k0bura/compaq-wifimodem/reference/photos/modem-top-both-connectors.jpg

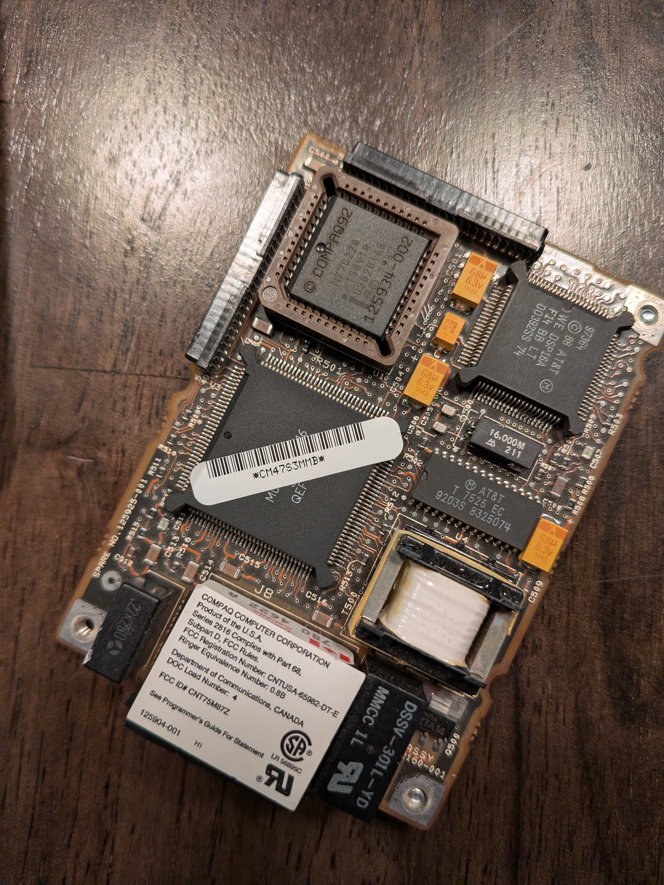
reference/photos/modem-top-both-connectors.jpg
