k0bura/compaq-wifimodem/reference/photos/modem-top-j4-removed.jpg

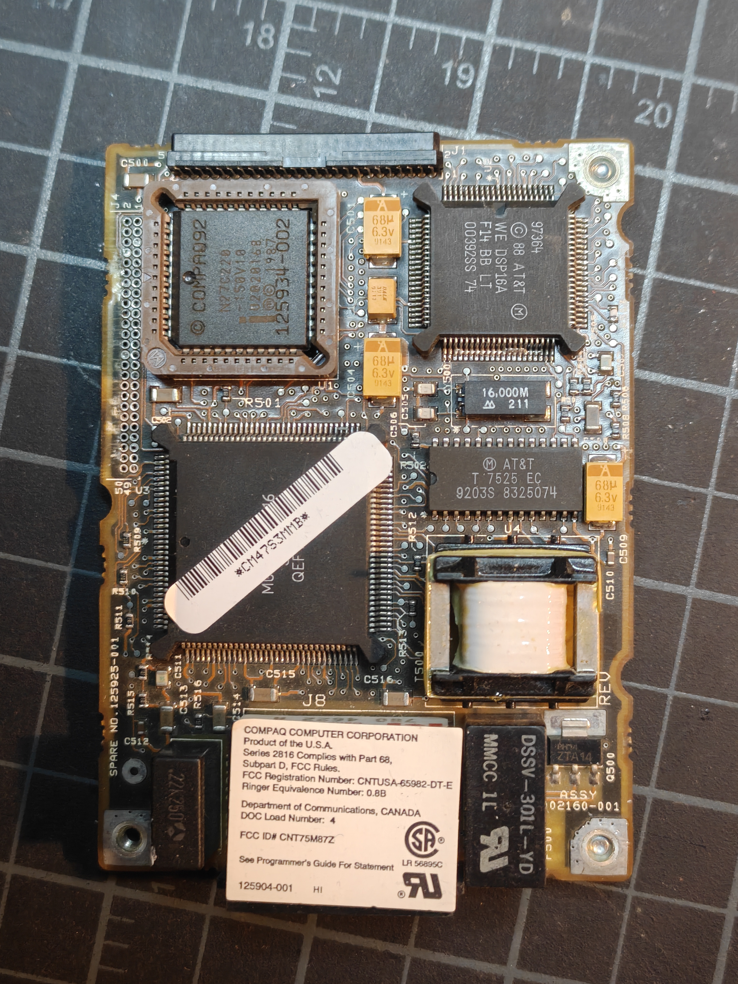
reference/photos/modem-top-j4-removed.jpg
