k0bura/compaq-wifimodem/reference/photos/modem-bottom.jpg

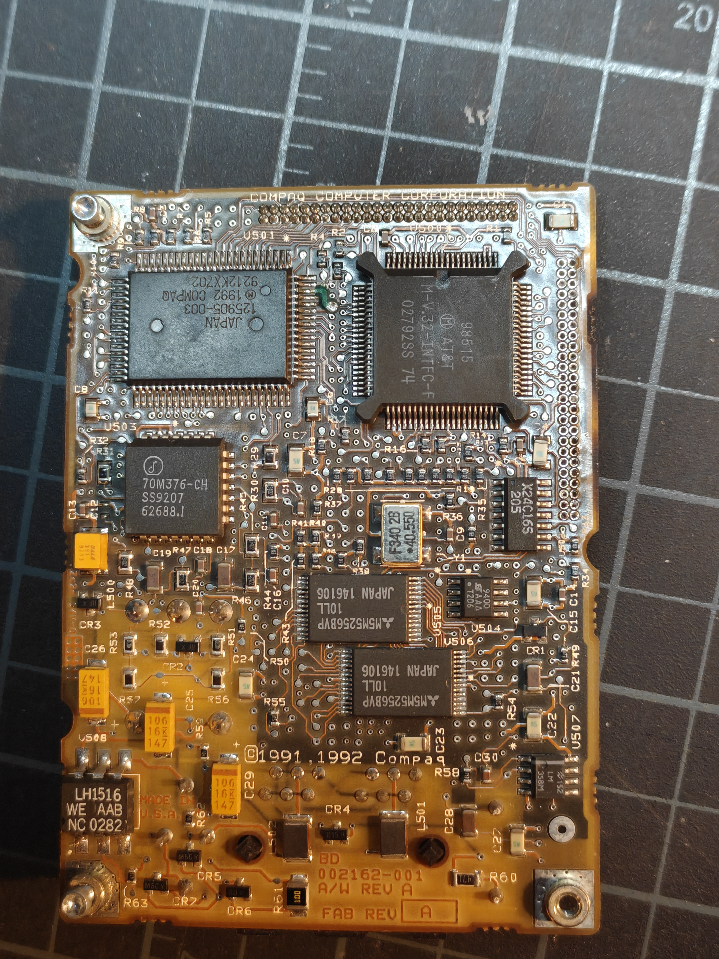
reference/photos/modem-bottom.jpg
