k0bura/compaq-wifimodem/reference/photos/modem-connector-edge-on.jpg

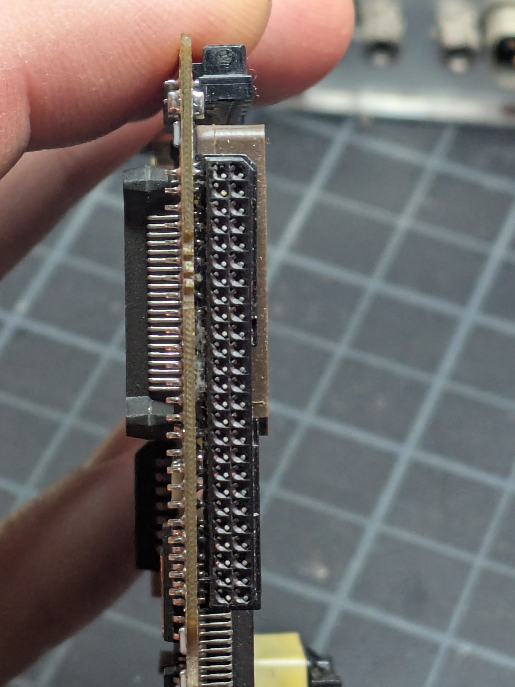
reference/photos/modem-connector-edge-on.jpg
