k0bura/compaq-wifimodem/reference/photos/modem-top-j4-removed-rotated.jpg

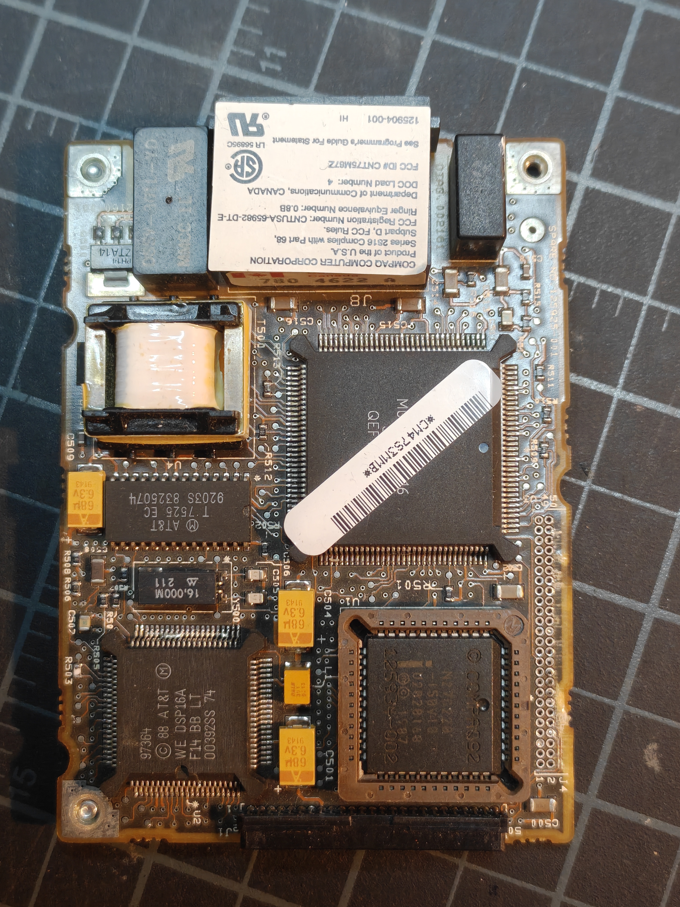
reference/photos/modem-top-j4-removed-rotated.jpg
