k0bura/compaq-wifimodem/reference/photos/slot-j22-closeup.jpg

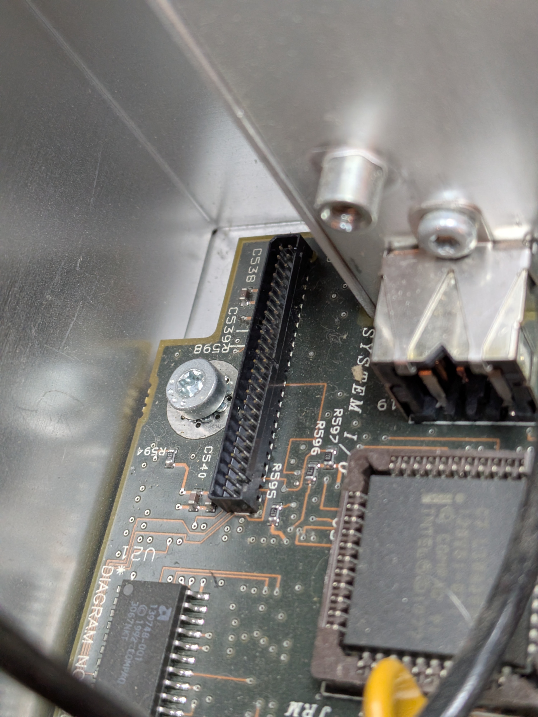
reference/photos/slot-j22-closeup.jpg
