k0bura/compaq-wifimodem/reference/photos/slot-j22-system-io-board.jpg

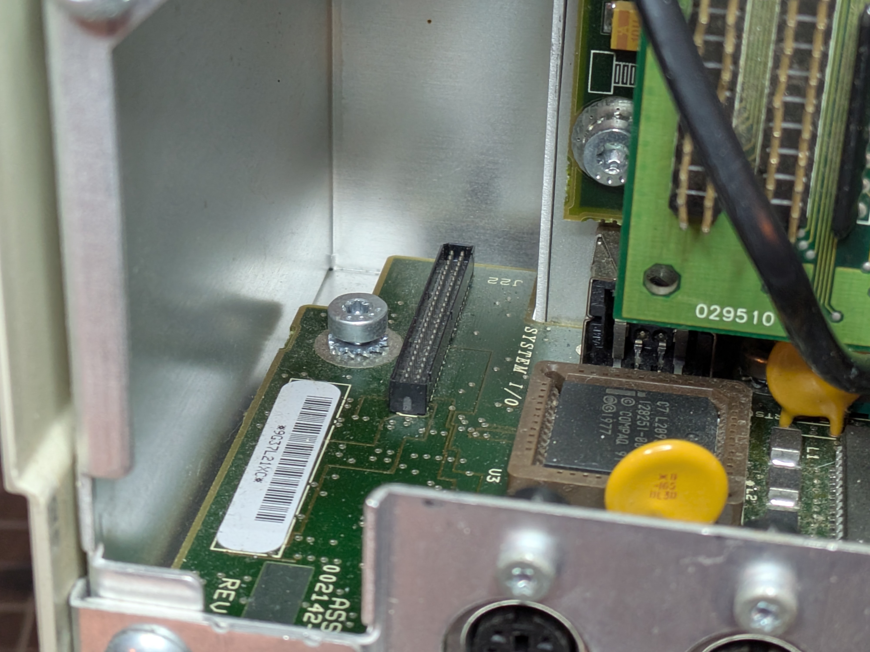
reference/photos/slot-j22-system-io-board.jpg
