k0bura/compaq-wifimodem/hardware/eos-breakout/eos-breakout-1to1.pdf

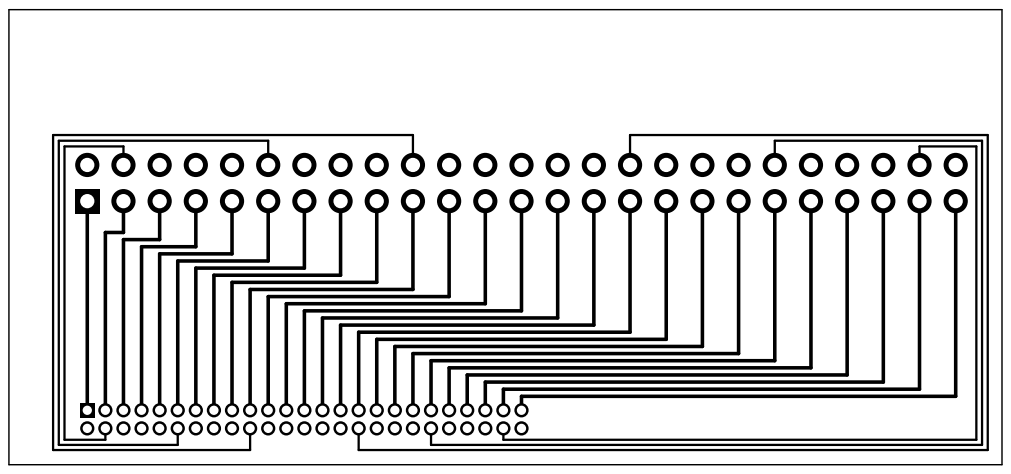
[picture p8: page 1]
