k0bura/compaq-wifimodem/(commit log)

2026-02-16 add reference material
2026-11-09 Rework plan around a 16C550 and correct the slot reference
    Cross-checked the plan against the LTE Lite guide, which documents the
    same 50-pin slot with signal directions and functions.
    - PLAN.md: 16C550 on the bus with the ESP32 on its serial side, replacing
    ESP32 emulation of the UART registers. Corrected address mapping
    (pin 18 = A0), SLOT IOEN- as a card output, and 3.3V-powered LVC parts
    for level shifting. Added passive sniffing and modem-tracing steps.
    - Slot reference: per-pin direction and function, LTE Lite configuration
    registers, OCR name corrections, odd/even pin numbering, and the
    original modem's component list.
    - Photos of the slot header (J22) and the original Comp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
2026-11-10 Add Enhanced Options Slot breakout board and connector findings
    - hardware/eos-breakout: two-layer breakout carrying the original Compaq
    2x25 1.27 mm receptacle, fanned out to a labelled 2x25 0.1" header.
    Generated by gen_breakout.py (KiCad 10 pcbnew API), passes DRC, with
    Gerbers, drill files, a 1:1 print and a preview render. The 1:1 print
    has been checked against the modem's J4 holes.
    - PLAN.md: connector footprint (1.27 mm square grid, 2.55 mm from the
    edge, body on the bottom side), keyed J22 header, modem orientation in
    the 486c, and the 1.8432 MHz oscillator on the System I/O board.
    - Slot reference: likely modem identity, UART diagnostics evidence, and
    links to the bits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
    [eos-breakout-B_Cu.gbl, eos-breakout-B_Mask.gbs, eos-breakout-B_Silkscreen.gbo, eos-breakout-Edge_Cuts.gm1, eos-breakout-F_Cu.gtl, eos-breakout-F_Mask.gts, eos-breakout-F_Silkscreen.gto, eos-breakout-NPTH.drl]
2026-11-10 Add four-layer OSH Park variant of the breakout board
    The two-layer rev A was ordered from OSH Park, whose two-layer minimum is
    6 mil trace and space. Rev A's even-pin traces are 0.12 mm with 0.115 mm
    gaps, below that. Rev B spreads the even-pin escape over four layers
    (0.16 mm traces, 0.20 mm gaps, over 15 mil from the edge) and passes DRC
    against OSH Park's four-layer rules.
    gen_breakout.py takes an 'oshpark' argument for rev B and still
    reproduces rev A exactly by default. PLAN.md records the order, the
    pre-solder continuity and shorts check, and both variants.
    [eos-breakout-oshpark-B_Cu.gbl, eos-breakout-oshpark-B_Mask.gbs, eos-breakout-oshpark-B_Silkscreen.gbo, eos-breakout-oshpark-Edge_Cuts.gm1, eos-breakout-oshpark-F_Cu.gtl, eos-breakout-oshpark-F_Mask.gts, eos-breakout-oshpark-F_Silkscreen.gto, eos-breakout-oshpark-job.gbrjob]
2026-11-10 Breakout: four-layer board is the ordered design, drop the two-layer variant
    The two-layer OSH Park order was cancelled and the four-layer board
    ordered instead. Remove the two-layer board files and their mentions,
    make gen_breakout.py generate the four-layer board only (output verified
    identical to the ordered file), rename the Gerbers to OSH Park's layer
    names, and regenerate the 1:1 print and preview from the ordered board.
    [eos-breakout-B_Cu.gbl, eos-breakout-B_Mask.gbs, eos-breakout-B_Silkscreen.gbo, eos-breakout-Edge_Cuts.gm1, eos-breakout-F_Cu.gtl, eos-breakout-F_Mask.gts, eos-breakout-F_Silkscreen.gto, eos-breakout-NPTH.drl]
2026-11-12 Plan: add antenna and status display, settle on purchased parts
    Reuse the case's phone-jack opening for an external WiFi antenna
    (U.FL to RP-SMA bulkhead) and an RJ12 jack for an I2C OLED status
    display. Record the chosen parts: TL16C550CFN in a PLCC44-DIP40
    adapter (the DIP-40 UART is obsolete), SN74LVC245AN for the 5V to
    3.3V direction, SN74HCT125N, and the conditional oscillator, decoder
    and inverter. Update the shopping list with what is on hand and what
    is in the Mouser cart.
2026-11-12 Record modem continuity tracing and mark Mouser parts ordered
    Tracing the original modem from its connector pads to the host-interface
    ASIC shows it takes SLOT CS-, A0-A2 and COMMCLK from the slot, does not
    see A3-A9, and leaves SLOT IOEN- unconnected. The card therefore needs
    no address decoder and leaves pin 49 unconnected, with a driven buffer
    kept as a fallback. Reset polarity and a running clock still need the
    powered machine.
